cee-wals/Voron-Tap/custom/scripts/voron_tap_part_checklist_data.csv

MGN9-Assembly-Tool.stl | MGN9-Assembly-Tool | 1 | Black | Not Printed | YES | NO | MGN9_Assembly_Tool.stl | Prusament ASA
Tap-Upper-PCB-r1.stl | Tap-Upper-PCB-r1 | 1 | Black | Not Printed | YES | NO | Tap_Upper_PCB_r1.stl | Prusament ASA
Tap-Magnet-Left-r1.stl | Tap-Magnet-Left-r1 | 1 | Black | Not Printed | YES | NO | Tap_Magnet_Left_r1.stl | Prusament ASA
Printed-Cut-Guide.stl | Printed-Cut-Guide | 1 | Black | Not Printed | YES | NO | Printed_Cut_Guide.stl | Prusament ASA
Tap-Magnet-Right-r1.stl | Tap-Magnet-Right-r1 | 1 | Black | Not Printed | YES | NO | Tap_Magnet_Right_r1.stl | Prusament ASA
[a]Tap-Center-r3.stl | [a]Tap-Center-r3 | 1 | Red | Not Printed | YES | NO | [a]Tap_Center_r3.stl | Prusament ASA
Tap-Front-r1.stl | Tap-Front-r1 | 1 | Black | Not Printed | YES | NO | Tap_Front_r1.stl | Prusament ASA
Tap-Upper-Wired-r1.stl | Tap-Upper-Wired-r1 | 1 | Black | Not Printed | YES | NO | Tap_Upper_Wired_r1.stl | Prusament ASA
