cee-wals/Voron-Tap/custom/3mf/in-progress/MGN9_Assembly_Tool.3mf

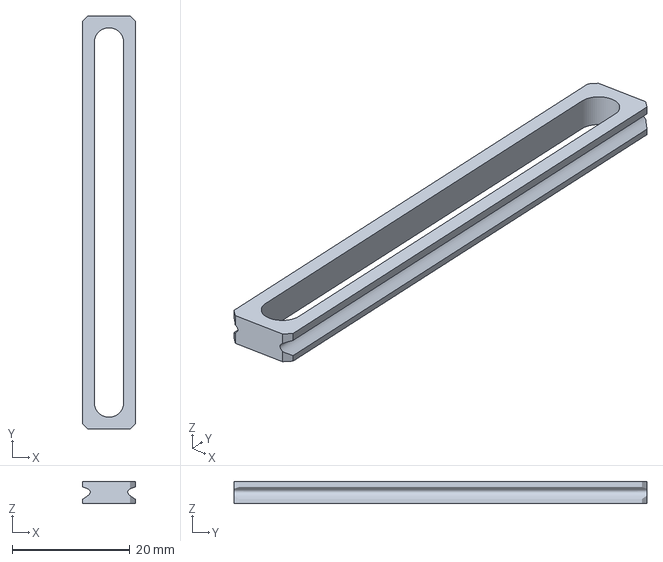
[picture p1: CAD file, 2022-12-21]
custom/3mf/in-progress/MGN9_Assembly_Tool.3mf
8.90 x 70.0 x 3.80 mm
