cee-wals/Voron-Tap/custom/3mf/in-progress/Tap_Upper_PCB_r1.3mf

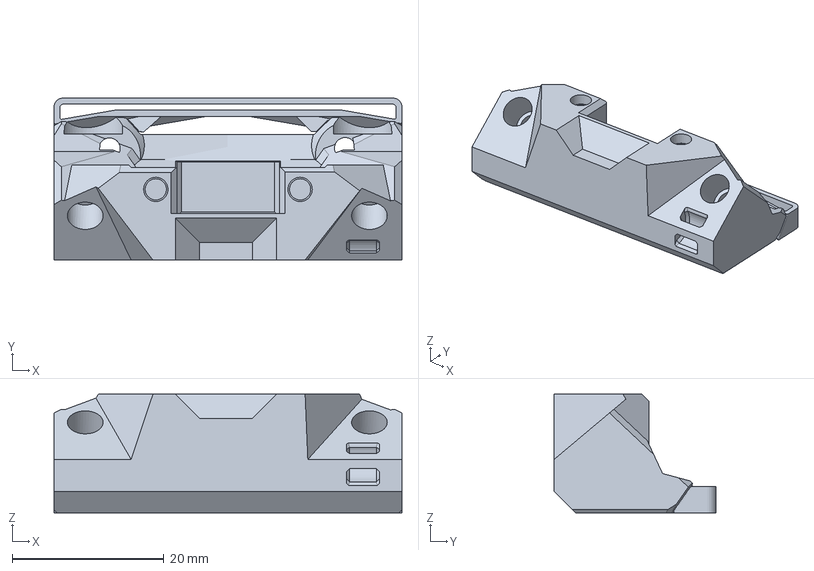
[picture p2: CAD file, 2022-12-21]
custom/3mf/in-progress/Tap_Upper_PCB_r1.3mf
45.8 x 21.3 x 15.6 mm
