cee-wals/Voron-Tap/STLs/Tap_Upper_Wired_r2.stl

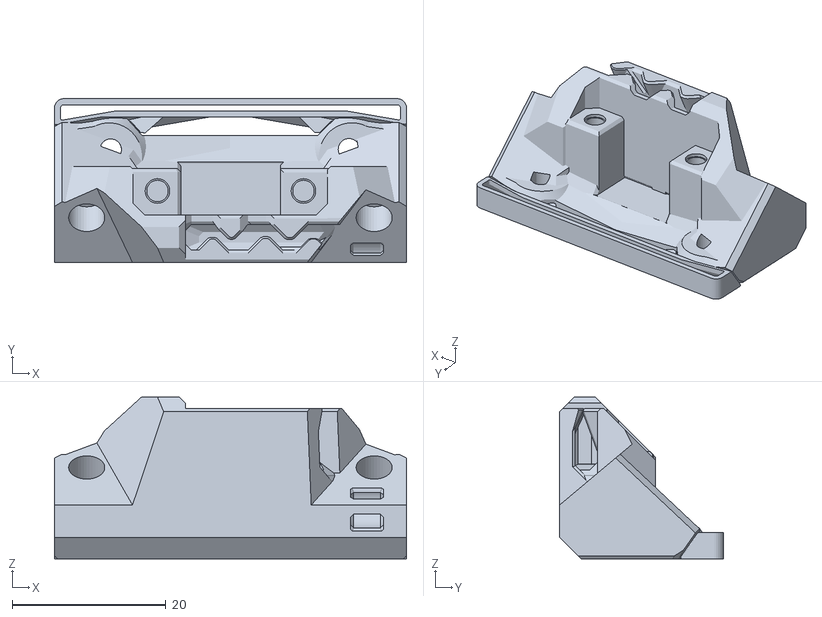
[picture p3: CAD file, 2023-02-01]
STLs/Tap_Upper_Wired_r2.stl
45.8 x 21.3 x 21.1
