cee-wals/Voron-Tap/custom/3mf/in-progress/Tap_Front_r1.3mf

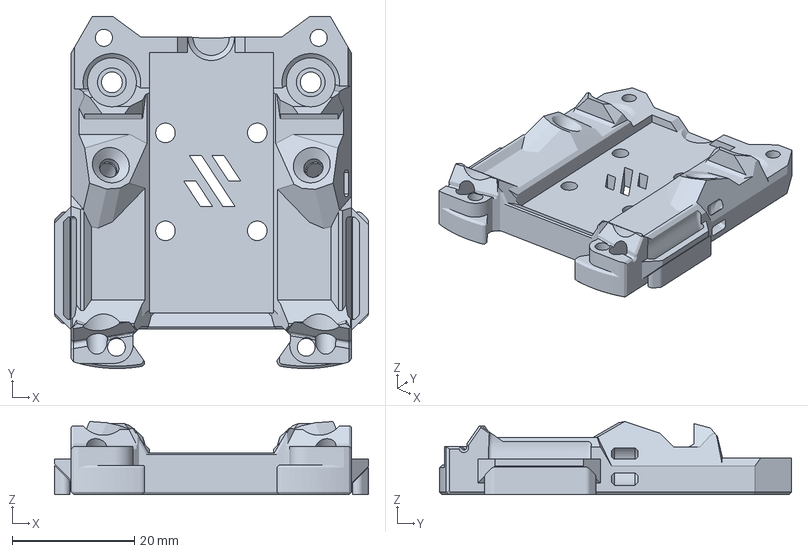
[picture p4: CAD file, 2022-12-21]
custom/3mf/in-progress/Tap_Front_r1.3mf
51.3 x 57.5 x 11.9 mm
