cee-wals/Voron-Tap/custom/3mf/in-progress/Tap_Magnet_Left_Right_r1.3mf

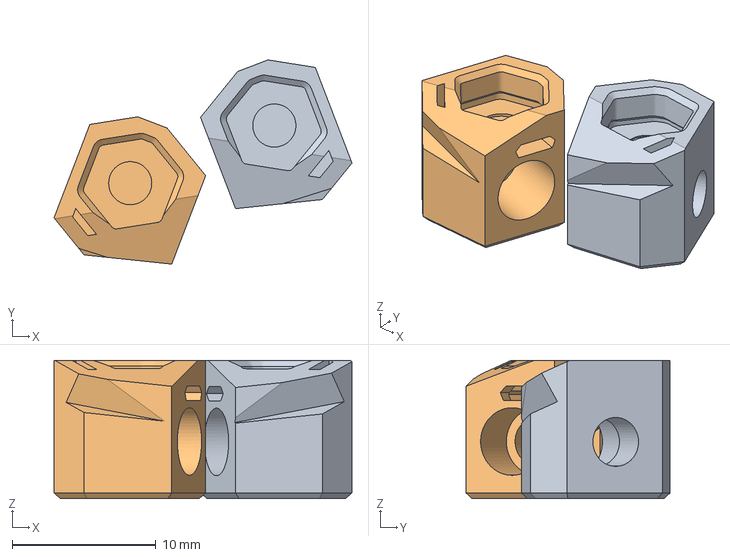
[picture p5: CAD file, 2022-12-21]
custom/3mf/in-progress/Tap_Magnet_Left_Right_r1.3mf
20.7 x 14.2 x 9.63 mm
Tap_Magnet_Right_r1.stl
Tap_Magnet_Left_r1.stl
