cee-wals/Voron-Tap/STLs/Tap_Upper_D2HW_r1.stl

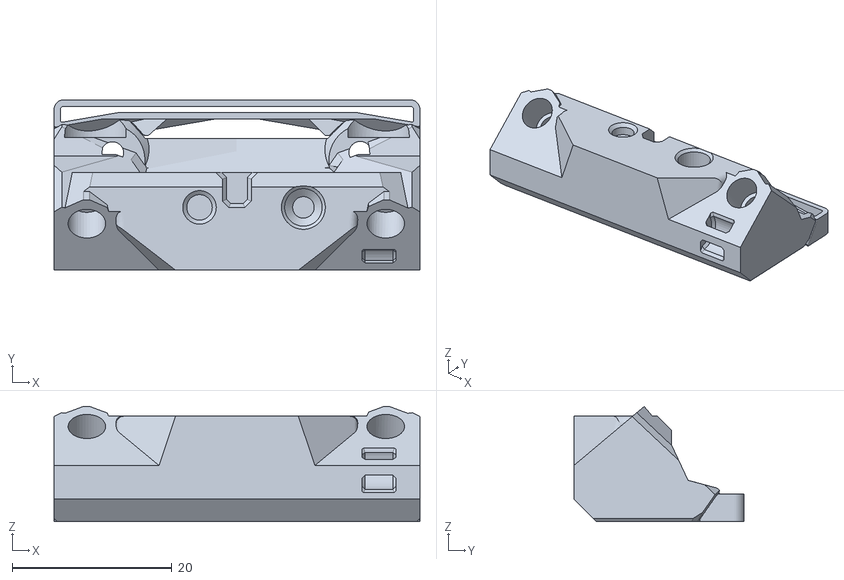
[picture p6: CAD file, 2023-02-01]
STLs/Tap_Upper_D2HW_r1.stl
45.8 x 21.3 x 14.4
