cee-wals/Voron-Tap/custom/3mf/in-progress/[a]Tap_Center_r3.3mf

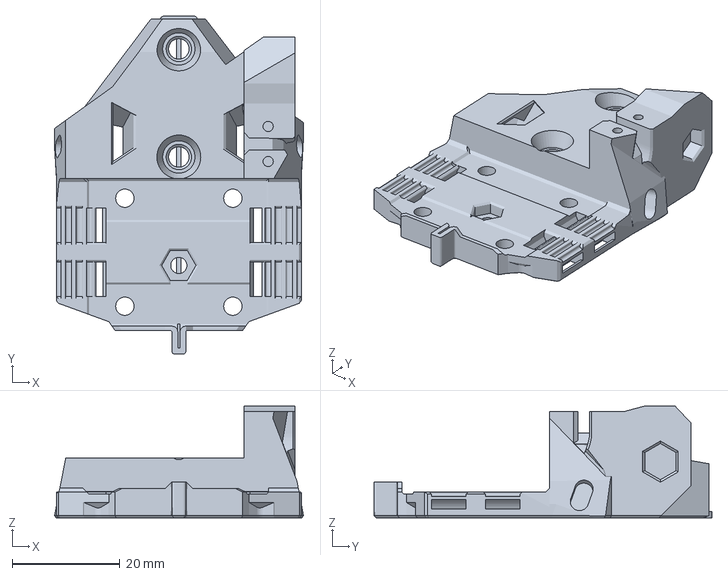
[picture p7: CAD file, 2022-12-21]
custom/3mf/in-progress/[a]Tap_Center_r3.3mf
46.1 x 62.6 x 20.7 mm
