cee-wals/Voron-Tap/STLs/Tap_Magnet_Left_r2.stl

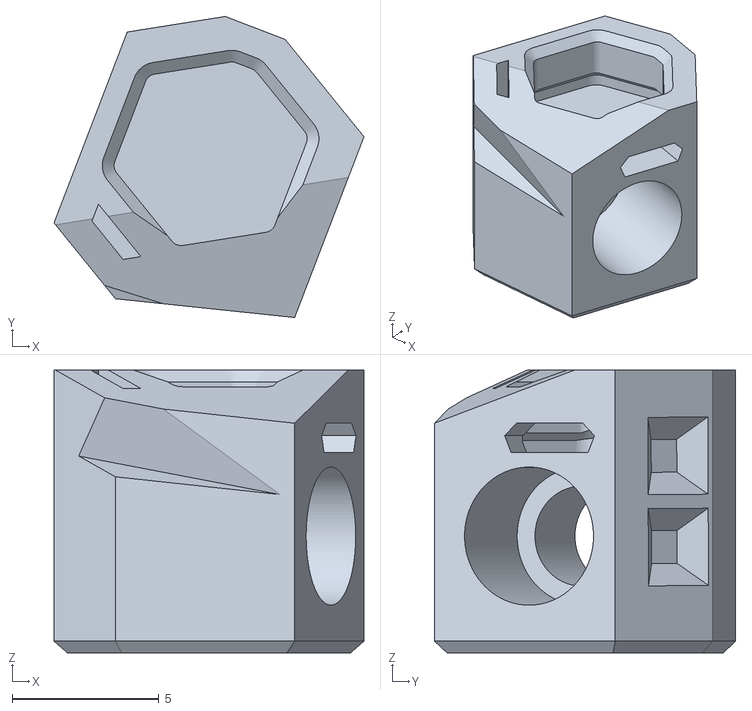
[picture p8: CAD file, 2023-02-01]
STLs/Tap_Magnet_Left_r2.stl
10.5 x 10.2 x 9.63
