cee-wals/Voron-Tap/STLs/Tap_Magnet_Right_r2.stl

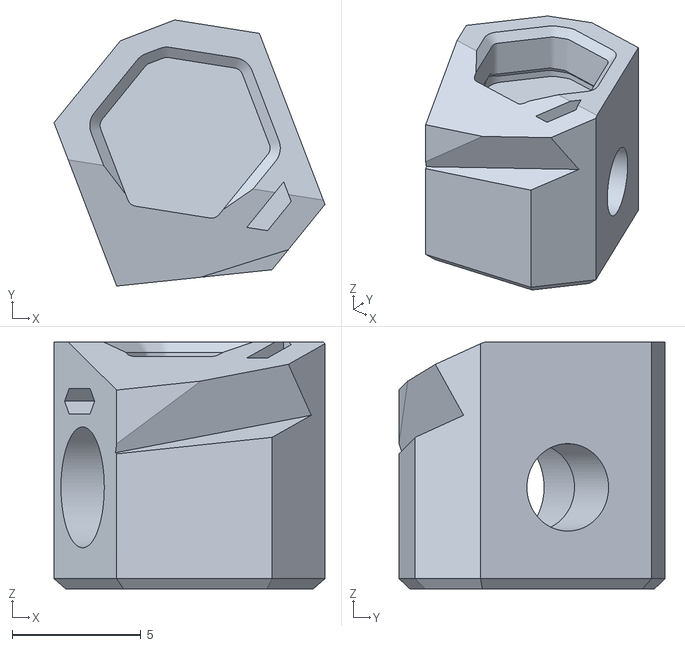
[picture p9: CAD file, 2023-02-01]
STLs/Tap_Magnet_Right_r2.stl
10.5 x 10.3 x 9.60
