cee-wals/Voron-Tap/(list of files, cad)

Other CAD files:
STLs/Tap_Front_r2.stl
STLs/Tap_Upper_PCB_r2.stl
STLs/[a]Tap_Center_r6.stl
